risebox/risebox-hard/README.md

# risebox-hard
Hardware Plans &amp; Specifications
