risebox/risebox-hard/fans/support_ventilateurs.docx

Ventilateurs :

Le support est fait de 2 tiges d'acier 1,2cm de largeur et 3mm d'épaisseur.

Risebox Ly-ja :

- Longueur tige acier : 42cm en haut et 36 en bas
- inclus rabas horizontal de 4cm

Trous de 4,2 Diamètre en bas écartés de 12cm (écartement des ventilos)
