risebox/risebox-hard/case/532358_da_en_01.pdf

Product Information | Page 1 of 2
EPIC® LS1 D6 6 Kontakte | Valid: 20.10.2010

## 3D/CAD Product data sheet

SKINTOP® ST

Product Description

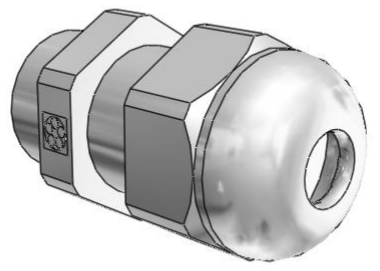
[picture p1: figure]
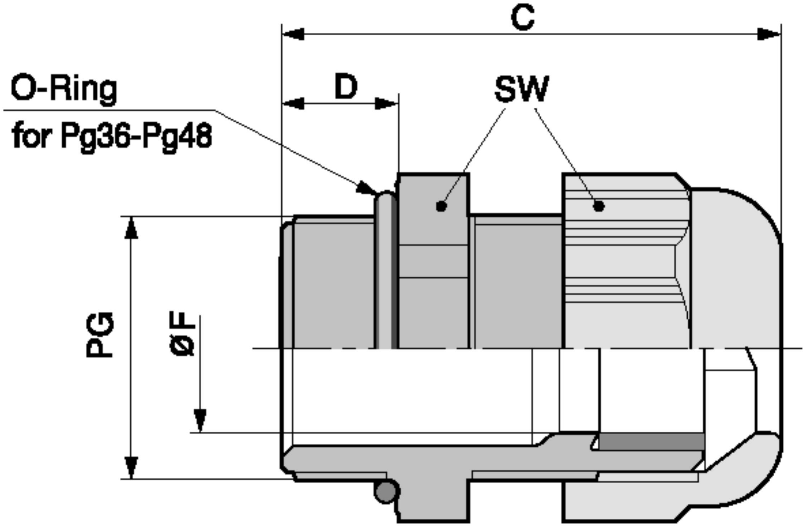
[picture p2: figure]

Product Information | Page 1 of 2
EPIC® LS1 D6 6 Kontakte | Valid: 20.10.2010

## 3D/CAD Product data sheet

SKINTOP® ST

Technical Data

ATN | 53018010
PG | PG 9
FMIN | 3.5
FMAX | 8
F | 3.5
SW | 19
A | 21.1
C | 36
D | 8
RAL7001
RAL7035 | X
RAL9005
MATERIAL

Kunststoff
