risebox/risebox-hard/lights/patron_leds.pdf

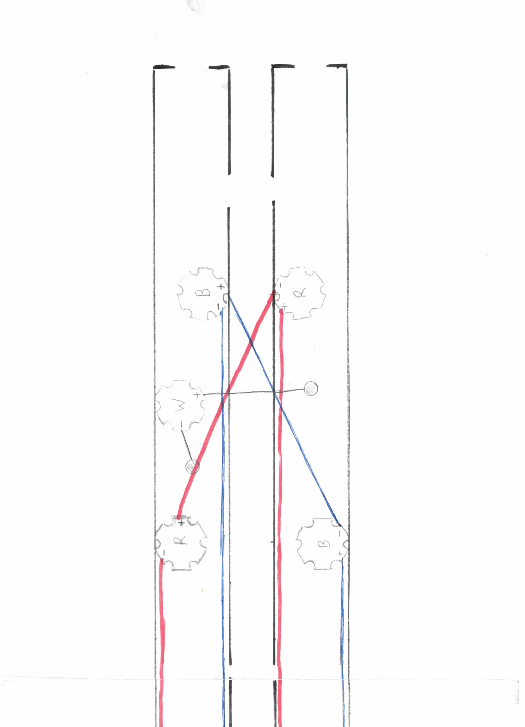
[picture p3: page 1]
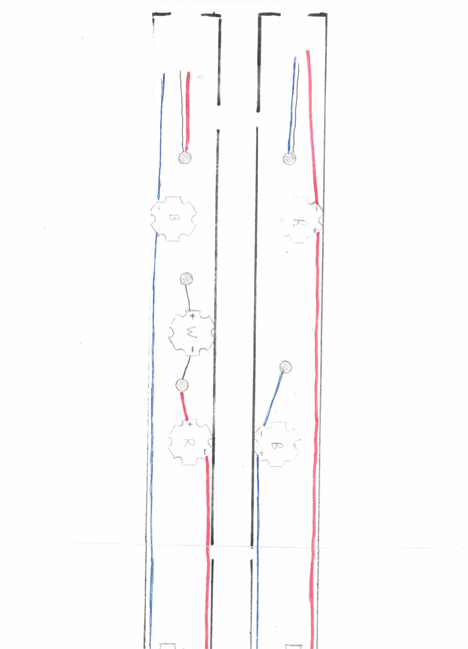
[picture p4: page 2]
