risebox/risebox-hard/electronics/chargeur.png

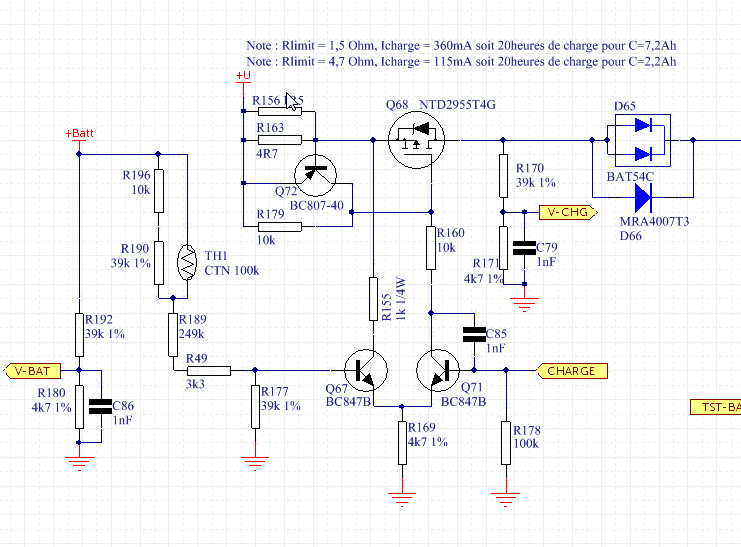
electronics/chargeur.png
