risebox/risebox-hard/case/BOM_CablagePresseEtoupe.xlsx

Repere topographique | Quantite | Description | Fabricant | Reference (fabricant) | SKU (référence RS / Farnell / DigiKey / Mouser) | Fournisseur (RS / FA / DK / MO) | web | commentaire
W1 | 5 | Câble multi blindé 4 cond 24 AWG | BELDEN | 9534 | 1218692 | FR | http://fr.farnell.com/belden/9534/cable-9534-4-conducteurs-au-metre/dp/1218692 | à vérifier les specs
W2 | 20 | Câble multi blindé 15 cond 24 AWG | ALPHA WIRE | 1219/15C SL005 | 828-2430 | RS | http://fr.rs-online.com/web/p/cable-industriel-multiconducteur/8282430/
W3 | 20 | Câble multi blindé 4 cond 20 AWG | ALPHA WIRE | 2414C SL005 | 168-1177 | RS | http://fr.rs-online.com/web/p/cable-industriel-multiconducteur/1681177/
W4 | 40 | Câble souple 22AWG Bleu | ALPHA WIRE | 3051/1 BL005 | 842-5343 | RS | http://fr.rs-online.com/web/p/fil-de-cablage-electrique/8425343/
W5 | 40 | Câble souple 22AWG Blanc | ALPHA WIRE | 3051/1 WH005 | 842-5390 | RS | http://fr.rs-online.com/web/p/fil-de-cablage-electrique/8425390/
W6 | 40 | Câble souple 22AWG Rouge | ALPHA WIRE | 3051/1 RD005 | 842-5378 | RS | http://fr.rs-online.com/web/p/fil-de-cablage-electrique/8425378/
C1 | 10 | Presse étoupe 3,5-8 Perçage 9 long vis 8 | LAPP KABEL | 53018010 | 807-9786 | RS | http://fr.rs-online.com/web/p/presse-etoupes/8079786/
C1 | 10 | Ecrou presse étoupe PG9 | LAPP KABEL | 53019011 | 817-2623 | RS | http://fr.rs-online.com/web/p/contre-ecrous/8172623/?origin=PSF_412597|acc
C2 | 3 | Presse étoupe 6-12 Perçage 13,5 long vis 8 | LAPP KABEL | 53015030 | 444-2638 | RS | http://fr.rs-online.com/web/p/presse-etoupes/4442638/
C2 | 3 | Ecrou presse étoupe PG13,5 | LAPP KABEL | 53019030 | 444-2723 | RS | http://fr.rs-online.com/web/p/contre-ecrous/4442723/?origin=PSF_412597|acc
C3 | 5 | Support fixation Rail DIN | WEIDMULLER |  | 286-4238 | RS | http://fr.rs-online.com/web/p/accessoires-de-borniers-pour-rail-din/2864238/?origin=PSF_435779|cav
