risebox/risebox-hard/electronics/hapy2.5/fabrication/PE_BrainRisebox.xlsx

Repere topographique | Quantite | Description | Fabricant | Reference (fabricant) | SKU (référence RS / Farnell / DigiKey / Mouser) | Fournisseur (RS / FA / DK / MO) | web | commentaire
C1,C18,C19 | 3 | Condensateur 10nF C_0402 | KEMET | C0402C103J3RACTU | 801-5151 | RS | http://fr.rs-online.com/web/p/condensateurs-ceramique-multicouche/8015151/ | à vérifier les specs
C3,C11 | 2 | Condensateur 10uF C1206 | MURATA | GRM31CC8YA106KA12L | 790-0594 | RS | http://fr.rs-online.com/web/p/condensateurs-ceramique-multicouche/7900594/?searchTerm=GRM31CC8YA106KA12L
C5,C13,C21,C22 | 4 | Condensateur 0.1uF C_0402 | TAIYO YUDEN | GMK105BJ104KV-F | 2113067 | FA | http://fr.farnell.com/taiyo-yuden/gmk105bj104kv-f/condensateur-mlcc-x5r-100nf-35v/dp/2113067
C6,C14 | 2 | Condensateur 12pF C_0402 | KEMET | C0402C120J3GACTU | 2332386 | FA | http://fr.farnell.com/kemet/c0402c120j3gactu/condensateur-mlcc-c0g-np0-12pf/dp/2332386
C7,C15 | 2 | Condensateur 120pF C_0402 | KEMET | C0402C121J5GACTU | 1572618 | FA | http://fr.farnell.com/kemet/c0402c121j5gactu/condensateur-mlcc-c0g-np0-120pf/dp/1572618
C8,C9,C16,C17 | 4 | Condensateur 47uF C_1206 | MURATA | GRM31CR60J476KE19L | 1828809 | FA | http://fr.farnell.com/murata/grm31cr60j476ke19l/condensateur-mlcc-x5r-47uf-6-3v/dp/1828809
C12,C4,C20 | 3 | Condensateur 0.1uF C_1206 | AVX | 12061C104JAT2A | 2332842 | FA | http://fr.farnell.com/avx/12061c104jat2a/condensateur-mlcc-x7r-100nf-100v/dp/2332842 | Changé à cause du 1206 => 10 % ça va ou faut 5 % ?
D1,D2 | 2 | Diode Schottky DO214AB | VISHAY | VS-30BQ040TRPBF | 8647879 | FA | http://fr.farnell.com/vishay-semiconductor/vs-30bq040trpbf/diode-schottky-boitier-smc-40v/dp/8647879
D3, D14, D17 | 3 | Diode Zener SOD-123 | ON SEMICONDUCTOR | MMSZ4678T1G | 1459115 | FA | http://fr.farnell.com/on-semiconductor/mmsz4678t1g/diode-zener-1-8v-0-5w-sod-123/dp/1459115
D18 | 1 | Diode Zener 1A DO-214AC | ON SEMICONDUCTOR | MRA4007T3G | 1459137RL | FA | http://fr.farnell.com/on-semiconductor/mra4007t3g/diode-standard-1a-1kv-sma/dp/1459137RL
D4,D6,D9,D12,D13,D16 | 6 | RS1A DIODE 1A DO-214AC | Fairchild | RS1A | 2454082 | FA | http://fr.farnell.com/fairchild-semiconductor/rs1a/rectifier-standard-1a-50v-do-214ac/dp/2454082
D5 | 1 | TRANSIL DO-214AA | STMicroelectronics | SMBJ26A/CA | 1749318 | FA | http://fr.farnell.com/stmicroelectronics/smbj26a-tr/transil-600w-26v-unidir-smb/dp/1749318
D7 | 1 | TRANSIL DO-214AA | STMicroelectronics | SMBJ15A/CA | 9886117 | FA | http://fr.farnell.com/stmicroelectronics/smbj15a-tr/diode-de-suppression-600w-15v/dp/9886117
D8,D15 | 2 | Diode LED Rouge 1608 | KINGBRIGHT | KPH-1608EC | 2426211 | FA | http://fr.farnell.com/kingbright/kph-1608ec/led-cms-8mcd-rouge-617nm/dp/2426211?ost=KPH-1608EC
D10 | 1 | Diode SOD-323 | NXP | PMEG2015EJ | 485-555 | RS | http://fr.rs-online.com/web/p/diodes-de-redressement-et-schottky/0485555/?searchTerm=PMEG2015EJ | A vérifier spec j'ai trouvé via référence
D11 | 1 | Diode LED Jaune 1608 | KINGBRIGHT | KPT-1608YC | 2099227 | FA | http://fr.farnell.com/kingbright/kpt-1608yc/led-jaune-0603-cms/dp/2099227?ost=KPT-1608YC
F1 | 1 | Porte fusible CMS | LITTELFUSE | 0154002.DR | 9943641 | FA | http://fr.farnell.com/littelfuse/0154002-dr/fusible-porte-fusibles-f-2a/dp/9943641
L1,L2 | 2 | Inductance self 16uA 6A | COILCRAFT | XAL6060-153MEC | 2289092 | FA | http://fr.farnell.com/coilcraft/xal6060-153mec/inductance-pwr-15uh-6a-20-11mhz/dp/2289092
P4 | 1 | PINHEAD 1-3 | TE Connectivity | 825433-3 | 3417657 | FA | http://fr.farnell.com/te-connectivity-amp/825433-3/barrette-droite-1-rangee-3voies/dp/3417657
Q1,Q4,Q6,Q7 | 4 | MOSFET Canal N SOT23 115mA | FAIRCHILD SEMICONDUCTOR | 2N7002 | 671-0312 | FA | http://fr.rs-online.com/web/p/transistors-mosfet/6710312/
Q2 | 1 | MOSFET Canal N SOT23 2.2A | FAIRCHILD SEMICONDUCTOR | FDN337N | 9845356 | FA | http://fr.farnell.com/fairchild-semiconductor/fdn337n/transistor-mosfet-n-sot-23/dp/9845356
Q3 | 1 | Transistor simple bipolaire (BJT), PNP SOT223 | NXP | BCP69,115 | 1081259 | FA | http://fr.farnell.com/nxp/bcp69-115/transistor-pnp-sot-223/dp/1081259
Q5,Q8 | 2 | MOSFET Canal P SOT 23 FET | INFINEON | BSS84P-H6327 | 1056526 | FA | http://fr.farnell.com/infineon/bss84p-h6327/transistor-mosfet-canal-p-boitier/dp/1056526
R1 | 1 | Resistance CMS 24.3K 1% 0603 | VISHAY DRALORIC | CRCW060324K3FKEA | 2138446 | FA | http://fr.farnell.com/vishay-draloric/crcw060324k3fkea/resistance-0603-24k3-1/dp/2138446
R2 | 1 | Resistance CMS 11.5K 1% 0603 | PANASONIC ELECTRONIC COMPONENTS | ERJP03F1152V | 2311932RL | FA | http://fr.farnell.com/panasonic-electronic-components/erjp03f1152v/resistance-erjp-11-5k-0603-0-2w/dp/2311932RL
R4, R11 | 2 | Resistance CMS 43.2K 1% 0603 | VISHAY DRALORIC | CRCW060343K2FKEA | 1469810 | FA | http://fr.farnell.com/vishay-draloric/crcw060343k2fkea/resistance-0603-43k2-1/dp/1469810
R5, R12 | 2 | Resistance CMS 143K 1% 0603 | PANASONIC ELECTRONIC COMPONENTS | ERJ3EKF1433V | 2303238 | FA | http://fr.farnell.com/panasonic-electronic-components/erj3ekf1433v/resist-couche-epaisse-143k-100mw/dp/2303238
R6, R13 | 2 | Resistance CMS 3.74k 1% 0603 | VISHAY DALE | CRCW06033K74FKEA | 1151910 | FA | http://fr.farnell.com/vishay-dale/crcw06033k74fkea/thick-film-resistor-3-74kohm-100mw/dp/1151910
R7, R14 | 2 | Resistance CMS 51.1ohm 1% 0603 | PANASONIC ELECTRONIC COMPONENTS | ERA3AEB51R1V | 708-7041 | RS | http://fr.rs-online.com/web/p/resistances-cms/7087041/ | C'est quoi la résstenace des 55.1 ohm ou kOhmk ?
R8, R15 | 2 | Resistance CMS 100k 1% 0603 | VISHAY | CRCW0603100KFKEAHP | 820-6745 | RS | http://fr.rs-online.com/web/p/resistances-cms/8206745/
R9 | 1 | Resistance CMS 680 ohms 1% 0603 | VISHAY | CRCW0603680RFKEA | 679-0627 | RS | http://fr.rs-online.com/web/p/resistances-cms/6790627/
R16 | 1 | Resistance CMS 17.4k 1% 0603 | PANASONIC ELECTRONIC COMPONENTS | ERJP03F1742V | 2311986RL | RS | http://fr.rs-online.com/web/c/passifs/resistances/resistances-cms/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
R17,R37,R50 | 3 | Resistance CMS 470 1% 0603 | VISHAY | CRCW0603470RFKEA | 679-0419 | RS | http://fr.rs-online.com/web/p/resistances-cms/6790419/
R18,R35,R42,R45,R51,R54,R57 | 7 | Resistance CMS 100 1% 0603 | TE Connectivity | CRG0603F100R | 213-2143 | RS | http://fr.rs-online.com/web/p/resistances-cms/2132143/
R22,R25,R26,R28,R31,R33,R34,R36 | 8 | Resistance CMS 1k 1% 0603 | TE Connectivity | CRG0603F1K0 | 213-2266 | RS | http://fr.rs-online.com/web/p/resistances-cms/2132266/
R20 | 1 | Resistance CMS 3.3k 1% 0603 | TE Connectivity | CRG0603F3K3 | 213-2339 | RS | http://fr.rs-online.com/web/p/resistances-cms/2132339/
R21 | 1 | Resistance CMS 1.8k 1% 0603 | VISHAY | CRCW06031K80FKEA | 678-9926 | RS | http://fr.rs-online.com/web/p/resistances-cms/6789926/
R19,R23,R24,R29,R30,R40,R43,R48,R52,R55,R56 | 11 | Resistance CMS 10k 1% 0603 | BOURNS | CR0603-FX-1002ELF | 740-8805 | RS | http://fr.rs-online.com/web/p/resistances-cms/7408805/
R27,R32 | 2 | Resistance CMS 4.7k 1% 0603 | BOURNS | CR0603-FX-4701ELF | 740-8877 | RS | http://fr.rs-online.com/web/p/resistances-cms/7408805/
R38 | 1 | Resistance CMS 12.4k 1% 0603 | VISHAY | CRCW060312K4FKEA | 678-9737 | RS | http://fr.rs-online.com/web/p/resistances-cms/6789737/
R46 | 1 | Resistance CMS 71.5k 1% 0603 | VISHAY | CRCW060371K5FKEA | 679-0689 | RS | http://fr.rs-online.com/web/p/resistances-cms/6790689/
R49 | 1 | Resistance CMS 200 1% 0603 | VISHAY | CRCW0603200RFKEA | 678-9960 | RS | http://fr.rs-online.com/web/p/resistances-cms/6789960/
R53 | 1 | Resistance CMS 16k 1% 0603 | VISHAY | CRCW060316K0FKEA | 678-9822 | RS | http://fr.rs-online.com/web/p/resistances-cms/6789822/
SW1 | 1 | Commutateur à glissière | KNITTER-SWITCH | MSS3112D | 711-8423 | RS | http://fr.rs-online.com/web/p/interrupteurs-a-coulisse/7118423/?searchTerm=MSS3112D
U1 | 1 | 2 Rails 2x23 Embase pour BBB Rev C | TE Connectivity | 5-826942-0 | 495-8486 | RS | http://fr.rs-online.com/web/p/embases-de-circuit-imprime/4958486/
U5 | 1 | LM317 SOT223 | TEXAS INSTRUMENTS | LM317MDCYRG3 | 1640686 | FA | http://fr.farnell.com/texas-instruments/lm317mdcyrg3/adjustable-linear-regulator-1/dp/1640686
BT1, P1, P2, P18, P19 | 5 | Bornier à vis 2.54 2 positions | Phoenix Contact | 1725656 | 220-4260 | RS | http://fr.rs-online.com/web/p/borniers-pour-ci/2204260/
P10, P15 | 2 | Bornier à vis 2.54 3 positions | Phoenix Contact | 1725669 | 220-4276 | RS | http://fr.rs-online.com/web/p/borniers-pour-ci/2204276/
P3, P5, P8, P9, P11, P12 | 6 | Bornier à vis 2.54 4 positions | Phoenix Contact | 1725672 | 651-1725672 | MO | http://www.mouser.fr/ProductDetail/Phoenix-Contact/1725672/?qs=sGAEpiMZZMv8kklI404QlYlnOTX4WPGR
P6, P7 | 2 | Bornier à vis 2.54 6 positions | Phoenix Contact | 1725698 | 220-4305 | RS | http://fr.rs-online.com/web/p/borniers-pour-ci/2204305/?searchTerm=MPT+0.5%2F+6-2.54&sra=p
C2, C10 | 2 | Condensateur céramique 10 nF 1206 | KEMET | C1206C103K5RACTU | 264-4141 | RS | http://fr.rs-online.com/web/p/condensateurs-ceramique-multicouche/2644141/
U2, U3 | 2 | DCDC Buck 4.5v to 28v | TEXAS INSTRUMENTS | TPS54335ADDA | 2346999 | FA | http://fr.farnell.com/texas-instruments/tps54335adda/buck-1-5mhz-4-5v-to-28v-3a-soic/dp/2346999
R3, R10 | 2 | Résistance 220k 1% 0805 | WELWYN | WCR0805-220KFI | 1099818 | FA | http://fr.farnell.com/welwyn/wcr0805-220kfi/resistance-0805-220k/dp/1099818
P20 | 1 | Connecteur fil-à-carte | AMPHENOL | T821126A1S100CEU | 2215311 | FA | http://fr.farnell.com/amphenol/t821126a1s100ceu/header-vertical-2-54mm-26way/dp/2215311
R41 | 1 | Résistance 56 ohms 1% 1206 | VISHAY | CRCW120656R0FKEAHP | 812-1922 | RS | http://fr.rs-online.com/web/p/resistances-cms/8121922/
R44 | 1 | Résistance 10k ohms 1% 0805 | TE Connectivity | CRG0805F10K | 223-0562 | RS | http://fr.rs-online.com/web/p/resistances-cms/2230562/
R47 | 1 | Résistance 11.8k ohms 1% 0805 | PANASONIC ELECTRONIC COMPONENTS | ERJ6ENF1182V | 814-0563 | RS | http://fr.rs-online.com/web/p/resistances-cms/8140563/
R39 | 1 | Résistance 1.2k ohms 1% 0805 | VISHAY | CRCW08051K20FKEAHP | 812-3448 | FA | http://fr.farnell.com/vishay-dale/crcw08055k00fkta/thick-film-resistor-5kohm-125mw/dp/1835558
