risebox/risebox-hard/case/brain_wiring.ods

Brain Wiring
Cable 4 | Longueur 180, gainé sur 110
Sondes | Cable 4 | Vert | RFANS
 |  | Jaune | LFANS
 |  | Marron | AHUM
 |  | Noir | AHUM
 |  | BleuClair | AHUM
 |  | BleuF | PWM UPPER_LEDS
 |  | Rouge | PWM UPPER_LEDS
 |  | Blanc | PWM UPPER_LEDS
