risebox/risebox-hard/electronics/hapy2.5/fabrication/hapy2-CoucheParCouche.pdf

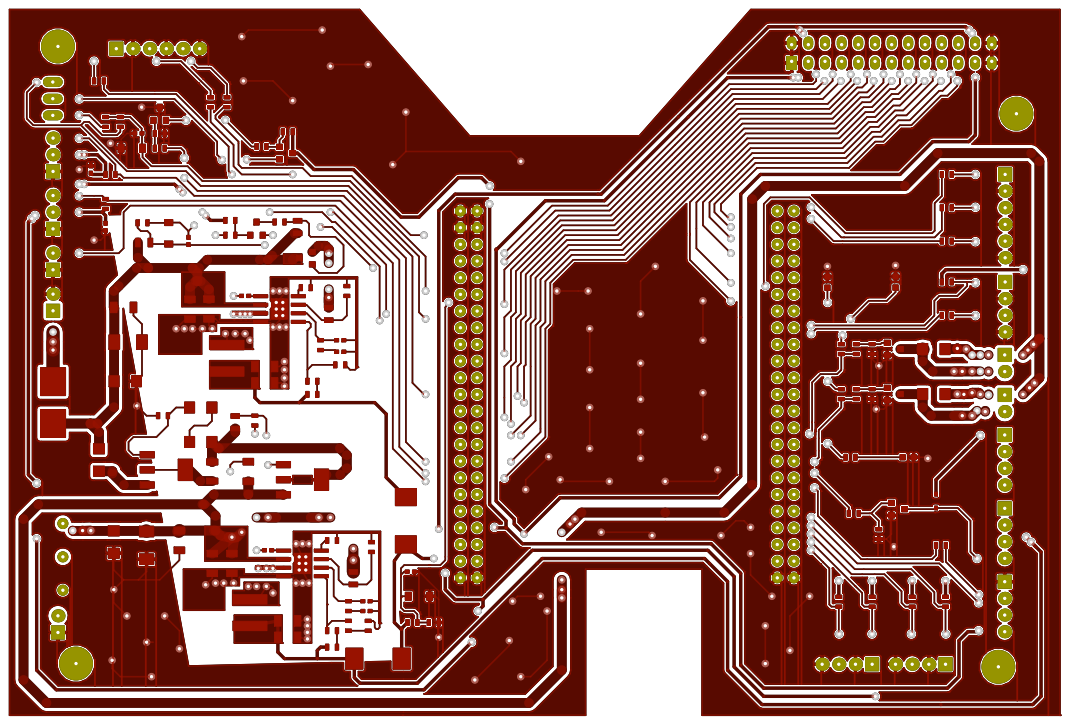
[picture p11: page 1]

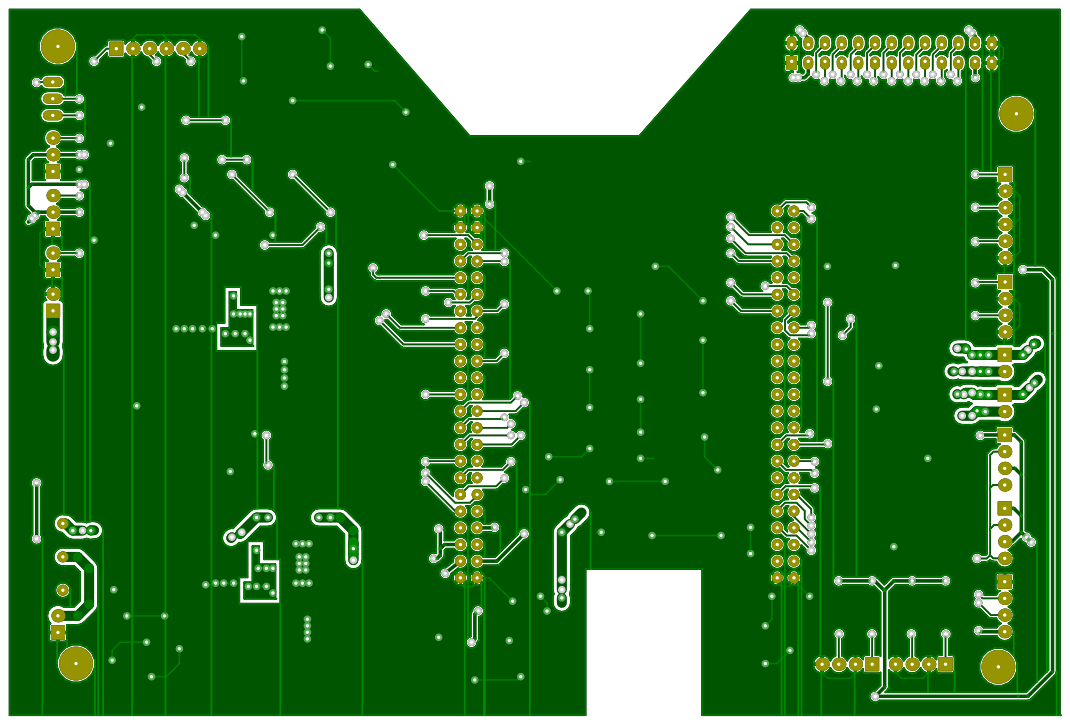
[picture p12: page 2]

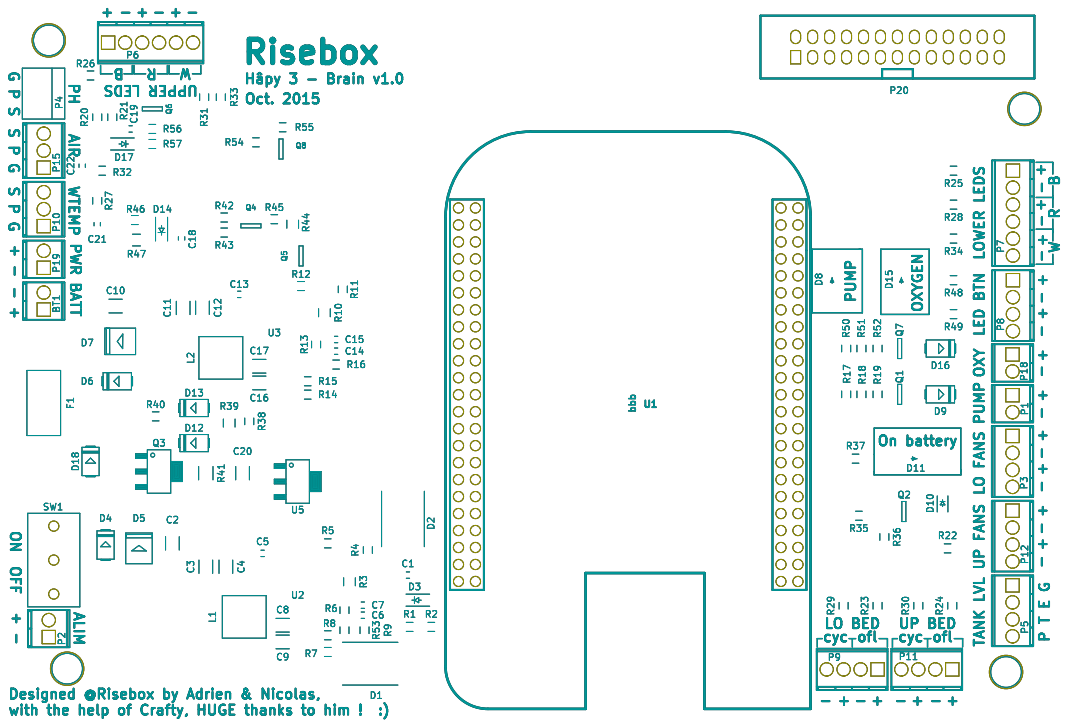
[picture p13: page 3]
