risebox/risebox-hard/electronics/hapy2.5/fabrication/hapy2-FrontSuperpose.pdf

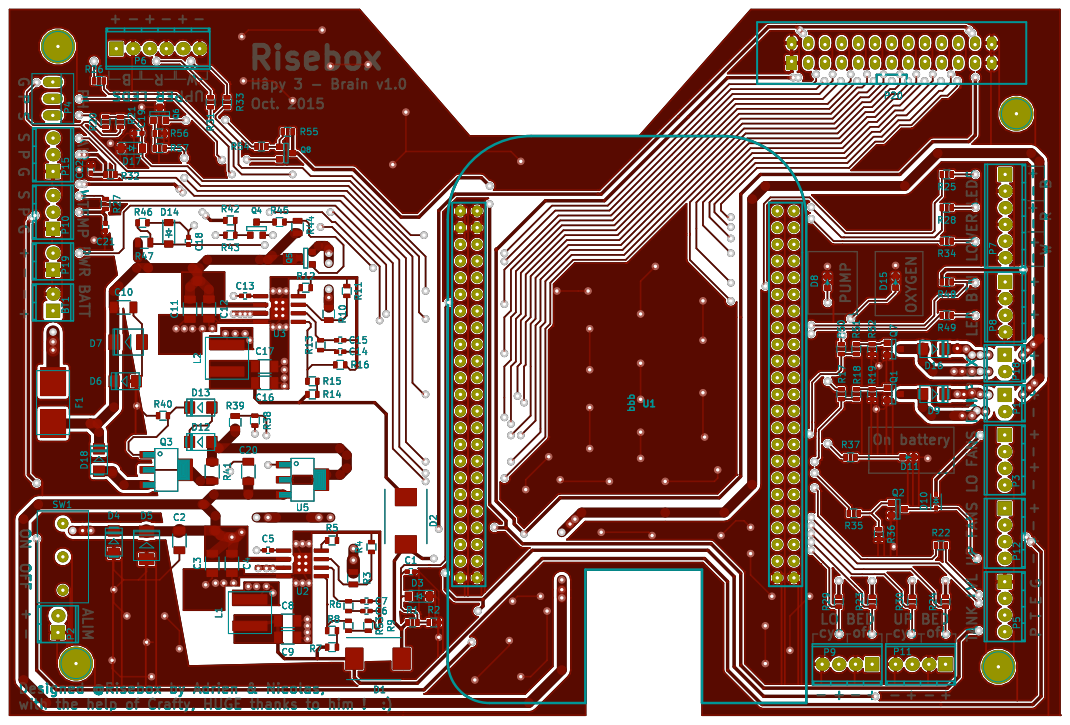
[picture p14: page 1]
