risebox/risebox-hard/(commit log)

2015-09-24 added schematics and kicad project
    [air-control.sch, battery.sch, brain.sch, fans.sch, hapy2.sch, main-power.sch, pump-control.sch]
2015-09-24 switch footprint libs to project local ones
2015-09-24 double check all component to footprint matches
    [air-control.sch, battery.sch, brain.sch, fans.sch, hapy2.sch, main-power.sch, pump-control.sch]
2015-09-24 better borniers
    [air-control.sch, battery.sch, brain.sch, fans.sch, hapy2.sch, main-power.sch, pump-control.sch]
2015-09-24 power hackport with direct 5v vs bbb 5V
    [air-control.sch, battery.sch, brain.sch, fans.sch, hapy2.sch, main-power.sch, pump-control.sch]
2015-09-24 creation of pcbs, raw components mapping
    [hapy2.kicad_pcb]
2015-09-24 battery level pin is now AIN2
    [air-control.sch, battery.sch, brain.sch, fans.sch, hapy2.kicad_pcb, hapy2.sch, main-power.sch, pump-control.sch]
2015-09-24 wip pcb
    [hapy2.kicad_pcb]
2015-09-25 routing P8 in progress
    [battery.sch, brain.sch, hapy2.kicad_pcb, hapy2.sch]
2015-09-25 pcb: added water & air relays
    [air-control.sch, hapy2.kicad_pcb, hapy2.sch, pump-control.sch]
2015-09-25 pcb: control panel & lower legs
    [hapy2.kicad_pcb]
2015-09-26 all tracks to bbb and borniers are now backside plus avoid front and back tracks side by side
    [air-control.sch, battery.sch, brain.sch, fans.sch, hapy2.kicad_pcb, hapy2.sch, main-power.sch, pump-control.sch]
2015-09-26 several vias on big tracks
    [hapy2.kicad_pcb]
2015-09-27 change C2 footprint to accomodate larger track
    [hapy2.kicad_pcb, main-power.sch]
2015-09-27 wip dcdc
    [hapy2.kicad_pcb]
2015-09-27 dcdc alim done
    [hapy2.kicad_pcb]
2015-09-27 dcdc alim really done
    [hapy2.kicad_pcb]
2015-09-27 most connectors done
    [hapy2.kicad_pcb]
2015-09-28 missing power routes
    [hapy2.kicad_pcb]
2015-09-28 added power routes to p9 probes
    [hapy2.kicad_pcb]
2015-09-28 free space for battery circuit
    [hapy2.kicad_pcb]
2015-09-28 route hackport and some alim twirks
    [brain.sch, hapy2.kicad_pcb]
2015-09-28 2nd dcdc and charger circuit done
    [battery.sch, hapy2.kicad_pcb]
2015-09-28 added batery level routes
    [hapy2.kicad_pcb]
2015-09-28 connected the 2 dcdc circuits
    [hapy2.kicad_pcb]
2015-09-28 center the board on the page
    [hapy2.kicad_pcb]
2015-09-28 cut the edge of the board
    [hapy2.kicad_pcb]
2015-09-29 added mounting holes
    [hapy2.kicad_pcb]
2015-09-29 routing complete
    [hapy2.kicad_pcb]
2015-09-29 visual ajustment
    [hapy2.kicad_pcb]
2015-09-29 12V routing around Q5
    [hapy2.kicad_pcb]
2015-09-29 plan de masse et cheveux manquants
    [hapy2.kicad_pcb]
2015-09-29 all conectiosn are OK
    [hapy2.kicad_pcb]
2015-09-29 prettier route for 3.3v
    [hapy2.kicad_pcb]
2015-09-29 better routing for ground plan
    [hapy2.kicad_pcb]
2015-09-29 plan de masse sur le recto et vias partout
    [hapy2.kicad_pcb]
2015-09-29 missing gnd vias
    [hapy2.kicad_pcb]
2015-09-29 repair gnd pads around dcdc
    [hapy2.kicad_pcb]
2015-09-29 gerbers plus repaired pcb
    [battery.sch, brain.sch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]
2015-09-29 checked cvpcv avs pcbnew and zero disconnect
    [$battery.sch, $brain.sch, $hapy2.sch, hapy2.kicad_pcb]
2015-09-29 solid pads and route clearance around the edges
    [hapy2.kicad_pcb]
2015-09-29 reduce alim width and add clearance, plus schematics
    [$battery.sch, $brain.sch, $hapy2.sch, battery.sch, brain.sch, hapy2.kicad_pcb, hapy2.sch]
2015-09-30 correct errors in track width and pads too near
    [hapy2.kicad_pcb]
2015-09-30 enhanced schema and more room around ph probe slot
    [air-control.sch, battery.sch, brain.sch, fans.sch, hapy2.kicad_pcb, pump-control.sch]
2015-09-30 fix footprints
    [battery.sch, brain.sch]
2015-09-30 changed schema to reflect proper ph probe pin order
    [brain.sch]
2015-09-30 rerouted the ph probe and still green
    [hapy2.kicad_pcb]
2015-10-01 BOM gen & test with protoelectrique.com
    [PE_BrainRisebox.xlsx, hapy2.csv, hapy2_bom.csv]
2015-10-01 generateds gerbers files
    [hapy2.kicad_pcb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]
2015-10-01 better gnd plane and power track
    [hapy2.kicad_pcb]
2015-10-01 left bornier labels
    [hapy2.kicad_pcb]
2015-10-01 proper bornier labels
    [hapy2.kicad_pcb]
2015-10-01 all labels and refs OK
    [hapy2.kicad_pcb]
2015-10-01 board signatures and thank you
    [hapy2.kicad_pcb]
2015-10-01 post crafty review, wip
    [$brain.sch, air-control.sch, battery.sch, brain.sch, fans.sch, hapy2.sch, main-power.sch, pump-control.sch]
2015-10-01 new BOM after crafty help
    [PE_BrainRisebox.xlsx]
2015-10-02 BOM updated
    check vs previous versions
    [PE_BrainRisebox.xlsx]
2015-10-02 post review schema, cmp and wip pcb
    [$brain.sch, air-control.sch, battery.sch, brain.sch, fans.sch, hapy2.kicad_pcb, hapy2.sch, main-power.sch]
2015-10-02 post review pcb
    [hapy2.kicad_pcb]
2015-10-02 updated BOM
    [PE_BrainRisebox.xlsx]
2015-10-02 fix Q3 PNP and nicer label layouts in progress
    [battery.sch, hapy2.kicad_pcb]
2015-10-02 proper labels for refs
    [hapy2.kicad_pcb]
2015-10-02 last labels
    [hapy2.kicad_pcb]
2015-10-02 kicad bom generated
    [hapy2.csv, hapy2_bom.csv]
2015-10-02 Finish bom before upload kicad and move to fab folder
    [PE_BrainRisebox.xlsx]
2015-10-02 fabrication files
    [hapy2-B_Cu.gbl, hapy2-B_Mask.gbs, hapy2-Edge_Cuts.gbr, hapy2-Edge_Cuts.gm1, hapy2-F_Cu.gtl, hapy2-F_Mask.gts, hapy2-F_SilkS.gto, hapy2-drl_map.gbr]
2015-10-02 ready for proto elec
    [hapy2.kicad_pcb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]
2015-10-02 board prints in PDF
2015-10-16 last update bomb
    [PE_BrainRisebox.xlsx, PE_BrainRisebox_nosku.xlsx]
2015-10-16 Export & Print for fab
2015-10-16 create spec & Bom for case
    [BOM_CablagePresseEtoupe.xlsx]
2015-10-19 created LED doc
2015-11-11 evacuation eau
    [brain_wiring.ods]
2015-11-12 update incoming water schematics
2016-04-12 ledcontroller in progress backup
    [$distribution.sch, Blue.sch, Color3.sch, Color4.sch, Red.sch, dcdc_24_12.sch, dcdc_24_5.sch, leds-controller.sch]
2016-04-18 wip review crafty
    [Blue.sch, Color3.sch, Color4.sch, Red.sch, dcdc_24_12_5.sch, fan.sch, leds-controller.sch, usb_connector.sch]
2016-05-27 more electronic shit
    [fan.sch, leds-controller.sch, leds.sch, usb_connector.sch]
2016-05-27 DIY versions and begin netlists
    [Blue.sch, Color3.sch, Color4.sch, Red.sch, dcdc_24_12.sch, dcdc_24_12_5.sch, dcdc_24_5.sch, fan.sch]
2016-06-02 begin led routing
    [leds.kicad_pcb]
2016-06-14 wip bare diy controller
    [Blue.sch, Color1.sch, Color2.sch, Color3.sch, Color4.sch, Red.sch, dcdc_24_12.sch, dcdc_24_12_5.sch]
2016-06-15 wip bare diy controller - dcdc and refactor
    [Color1.sch, Color2.sch, Color3.sch, Color4.sch, DCDC_12_5.sch, dcdc_24_12_5.sch, fan.sch, leds-controller.sch]
2016-06-16 schema done - misses values
    [Color1.sch, Color2.sch, Color3.sch, Color4.sch, THERMIC_SECURITY.sch, dcdc_24_12_5.sch, leds-controller.sch]
2016-06-17 schema prctically ok missing refs
    [Color1.sch, DCDC_12_5.sch, THERMIC_SECURITY.sch, fan.sch, leds-controller.sch]
2016-06-17 bom refs etc
    [Color1.sch, DCDC_12_5.sch, THERMIC_SECURITY.sch, fan.sch, leds-controller.sch, signal_tensions.sch]
2016-06-20 simpler schematics with a lot of values now
    [Blue.sch, Color1.sch, Color2.sch, Color3.sch, Color4.sch, DCDC_12_5.sch, Red.sch, THERMIC_SECURITY.sch]
2016-06-22 Added missing Capa & Resistor values
    [Color1.sch, Color2.sch, Color3.sch, Color4.sch, leds-controller.sch]
2016-06-23 footprint with libraries
    [Color1.sch, Color2.sch, Color3.sch, Color4.sch, DCDC_12_5.sch, THERMIC_SECURITY.sch, fan.sch, leds-controller.sch]
2016-06-23 fix some errors
    [Color1.sch, Color2.sch, Color3.sch, Color4.sch, DCDC_12_5.sch, THERMIC_SECURITY.sch, leds-controller.sch]
2016-06-23 add pinhead footprint
    [Color1.sch, Color2.sch, Color3.sch, Color4.sch, THERMIC_SECURITY.sch]
2016-06-23 all components have now a footprint
    [leds-controller.sch]
2016-06-24 before routing - no more errors
    [Color1.sch, Color2.sch, Color3.sch, Color4.sch, DCDC_12_5.sch, THERMIC_SECURITY.sch, fan.sch, leds-controller.kicad_pcb]
2016-06-24 explode and group footprints on pcb
2016-06-24 modified KPH footprint
2016-06-24 added pin with lock footprint
    [Color1.sch, Color2.sch, Color3.sch, Color4.sch, leds-controller.sch]
2016-06-24 new netlist
    [leds-controller.kicad_pcb]
2016-06-27 updated LEDS footprint & TH ref
    [leds.sch]
2016-06-28 first routing of led
    [leds.kicad_pcb, leds.sch]
2016-06-29 led routing - one done
    [leds.kicad_pcb, leds.sch]
2016-06-29 2 leds
    [leds.kicad_pcb]
2016-06-29 ready for 4 leds routing
    [leds.kicad_pcb]
2016-06-29 new connector footprint
    [leds.kicad_pcb, leds.sch]
2016-06-30 2 last LEDs well positioned on PCB
    [leds.kicad_pcb]
2016-06-30 fini routage LEDS
    [leds.kicad_pcb]
2016-07-01 new position for connectors
    [leds.kicad_pcb]
2016-07-01 nouvelle position sonde
    [leds.kicad_pcb]
2016-07-01 1st attempt to route led drivers chip
    [leds-controller.kicad_pcb]
2016-07-02 generate gerber file
    [leds.kicad_pcb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]
2016-07-04 short routing for 1 color circuit
    [leds-controller.kicad_pcb]
2016-07-05 2nd color circuit
    [leds-controller.kicad_pcb]
2016-07-05 3rd color circuit
    [leds-controller.kicad_pcb]
2016-07-05 4rth color circuit
    [leds-controller.kicad_pcb]
2016-07-05 regenerated Gerber Files
    [leds.kicad_pcb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]
2016-07-05 wip routing all together
    [leds-controller.kicad_pcb]
2016-07-05 led outputs
    [leds-controller.kicad_pcb, leds-controller.sch]
2016-07-05 all is routed - optimisation possible
    [leds-controller.kicad_pcb]
2016-07-05 better potard alignment
    [leds-controller.kicad_pcb]
2016-07-06 plan de masse, et routage ok, reste clearance et finitions
    [leds-controller.kicad_pcb]
2016-07-06 all labels are now visible
    [leds-controller.kicad_pcb]
2016-07-06 Brand on board
    [leds-controller.kicad_pcb]
2016-07-07 missing tracks are back
    [leds-controller.kicad_pcb]
2016-07-07 all is well before front groud plane :)
    [leds-controller.kicad_pcb]
2016-07-07 all is well with both ground planes
    [leds-controller.kicad_pcb]
2016-07-07 only 4 drc errors left
    [leds-controller.kicad_pcb]
2016-07-08 no more DRC errors for LEDS
    [leds.kicad_pcb]
2016-07-08 better spacing for LEDs
    [leds.kicad_pcb]
2016-07-08 add ground zone on F Cu
    [leds.kicad_pcb]
2016-07-08 change via size and generate Gerber files
    [leds-controller-B.Cu.gbl, leds-controller-B.Mask.gbs, leds-controller-B.SilkS.gbo, leds-controller-Edge.Cuts.gm1, leds-controller-F.Cu.gtl, leds-controller-F.Mask.gts, leds-controller-F.SilkS.gto, leds-controller-NPTH.drl]
2016-07-08 proper drills and vias
    [leds-controller.kicad_pcb]
2016-07-08 no more bites
    [leds-controller.kicad_pcb]
2016-07-08 generate gerber files
    [leds-controller-B.Cu.gbl, leds-controller-B.Mask.gbs, leds-controller-B.SilkS.gbo, leds-controller-Edge.Cuts.gm1, leds-controller-F.Cu.gtl, leds-controller-F.Mask.gts, leds-controller-F.SilkS.gto, leds-controller.drl]
2016-07-08 new gerber files for less
    [leds.kicad_pcb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]
